UN7FGO/VFO_NANO_LCD_SI5351/V8/readme.md

# VFO_NANO_LCD_SI5351
# Экспериментальная версия V8




## 24.06.2024

Версия синтезатора на минималистичной печатной плате и двоичным выводом на дешифратор номера текущего диапазона.

Этот вариант программы собран на базе стабильной версии ПО для синтезатора V.1.5.

Не совместима по выводам, с предыдущими версиями печатных плат, поскольку изменены контакты входа S-метра и галлетного переключателя диапазонов. 

После сборки и проверки автором на работоспособность, будет добавлена подробная документация.

### Внимание!
### Версия экспериментальная. Все замечания и предложения можно отправлять на un7fgo(dog)gmail.com 

Печатная плата

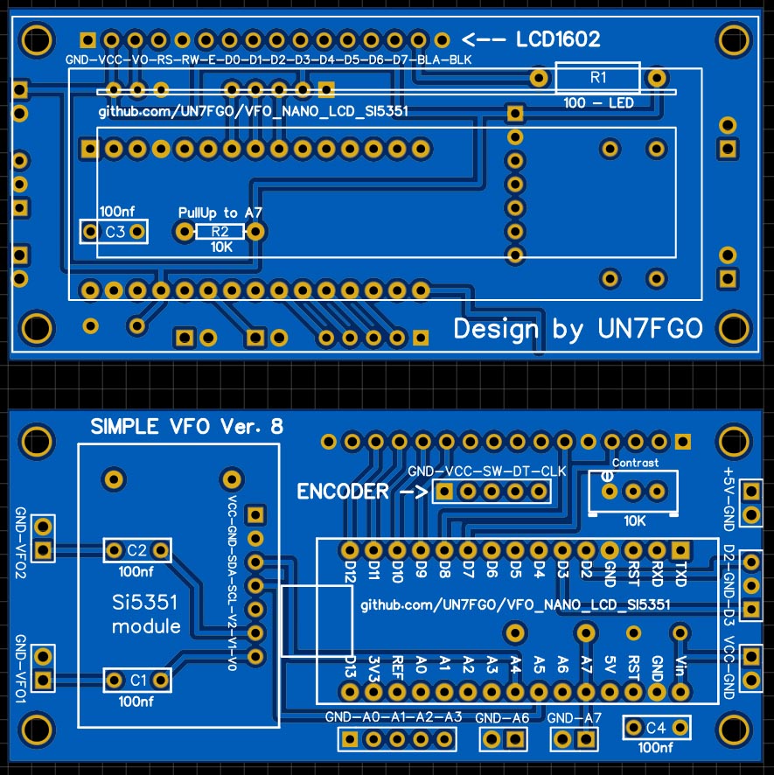
[picture p1: V8/VFO_V8_2D.jpg]
печатная плата


3Д-модель, без дисплея.

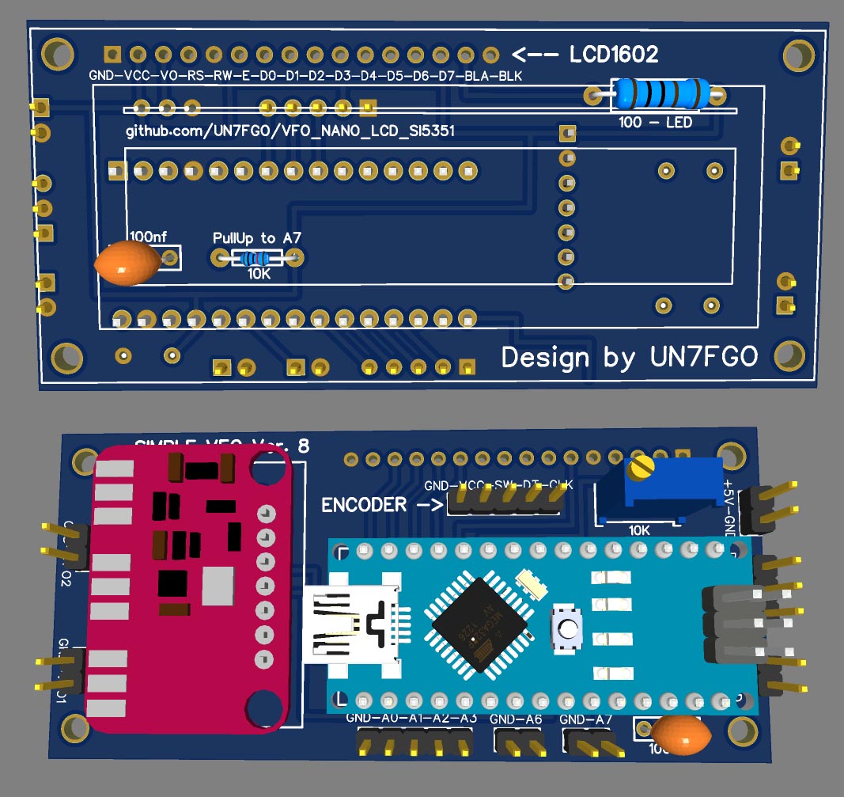
[picture p2: V8/VFO_V8_3D.jpg]
модель
