UN7FGO/VFO_NANO_LCD_SI5351/PCB_V2/Readme.md

# Уменьшенный вариант печатной платы синтезатора.

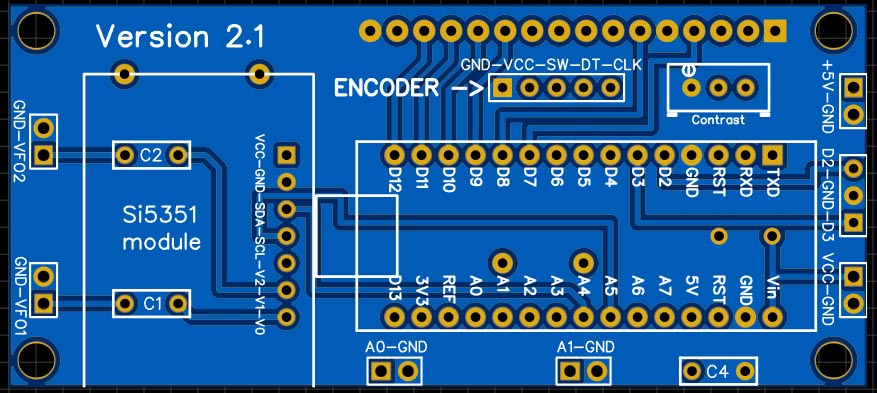
[picture p3: PCB_V2/pcb_V2_1.jpg]
Печатная платта
