UN7FGO/VFO_NANO_LCD_SI5351/PIXIE_MOD/README.md

Режим добавлен по просьбе участников форума QRP.RU.

К сожалению, печатная плата пока для него не изготовлена.

Дополнительные настройки описаны в приложенной документации на странице Меню.

На предпоследней странице инструкции описаны особенности режима и как его реализовать своими руками.

Режим находится в стадии тестирования.
