UN7FGO/VFO_NANO_LCD_SI5351/CH340_DRIVER/readme.md

Здесь расположен драйвер для китайских плат Ардуино с чипом CH340
