UN7FGO/VFO_NANO_LCD_SI5351/PCB_FOR_LUT_BOTTOM.jpg

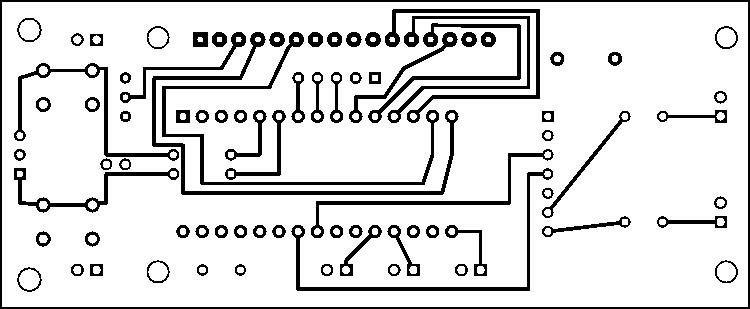
PCB_FOR_LUT_BOTTOM.jpg
