UN7FGO/VFO_NANO_LCD_SI5351/PCB_V2/pcb_V2.jpg

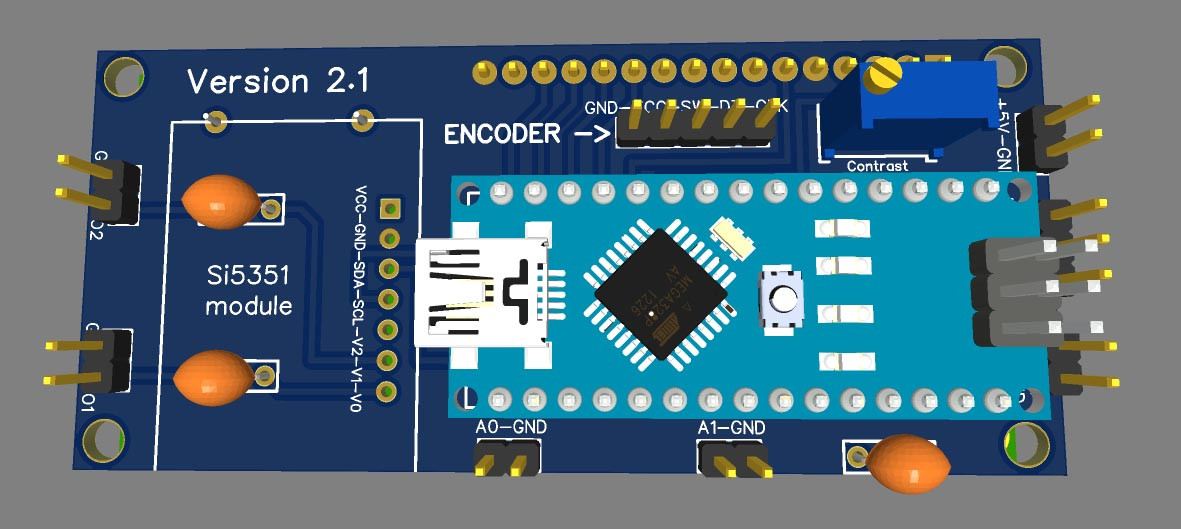
PCB_V2/pcb_V2.jpg
