UN7FGO/VFO_NANO_LCD_SI5351/VFO_PHOTO_2.jpg

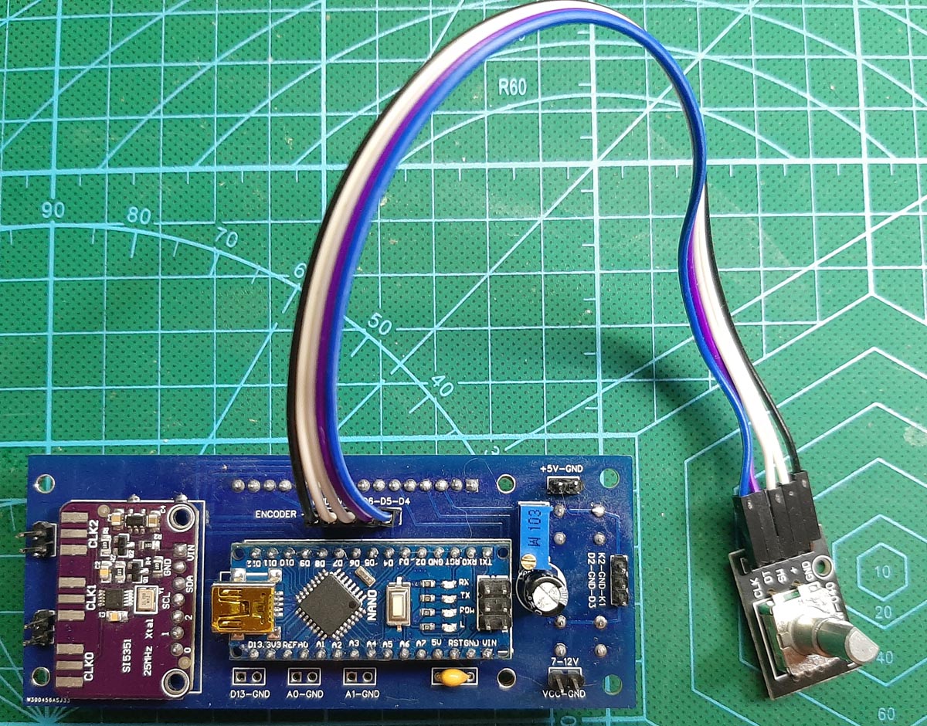
VFO_PHOTO_2.jpg
