UN7FGO/VFO_NANO_LCD_SI5351/V8/Schematic_VFO_NANO_LCD_SI5351_V8.pdf

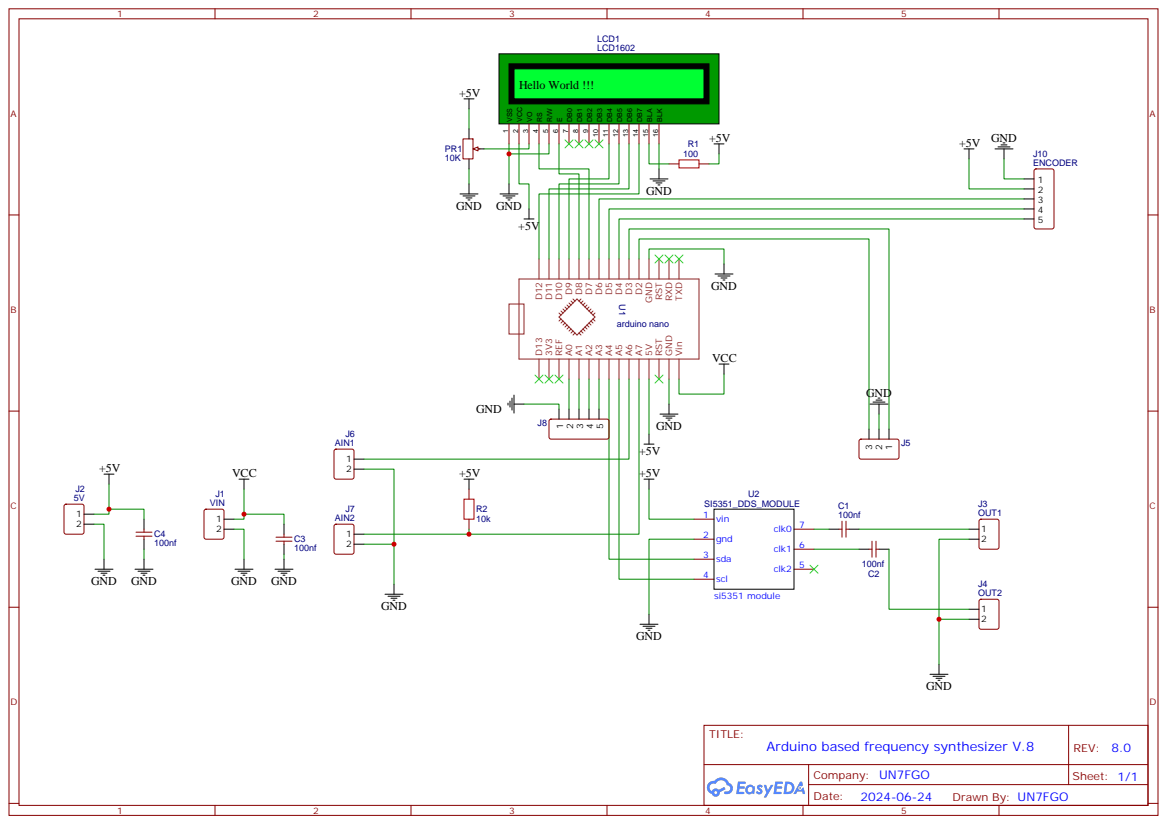
[picture p72: page 1]
