UN7FGO/VFO_NANO_LCD_SI5351/(commit log)

2022-12-28 Add new Gerber file
2022-12-28 Upload images of PCB
2022-12-28 Добавил описание второй версии печатной платы
2023-02-17 Дополнил описание
2023-02-17 Обновил описание проекта
